jaisor/SolarNodeChargeController/(commit log)

2026-10-28 feat: add CN3791 solar charger schematic with INA219 monitor
    KiCad 10 project for a 1S LiPo charger fed by up to four 5V solar panels,
    built from the CN3791 datasheet's typical application (Figure 1):
    - Panels on J1-J4, each isolated by a 1N5819 onto a shared PV bus.
    - 1.0A charge current (R5 = 0.12R) and a 4.58V MPPT setpoint (R3/R4),
    chosen so diode-isolated 5V panels sit near their max power point.
    - Datasheet blocking diode D1 omitted: the input diodes already stop
    back-feed into the panels, and it frees ~0.4V of headroom.
    - J7/J8 take off-board panel switches (battery cut-off, load only);
    J6 is the VOUT output to the powered module.
    - INA219 (0x40) reads either the solar shunt R7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
    [SolarNodeChargeController.kicad_pcb, SolarNodeChargeController.kicad_sch]
2026-10-28 feat(pcb): add component placement draft
    Place all 36 footprints on a 60 x 29 mm 2-layer board with nets assigned
    and no routing. Solar inputs and their 1N5819s run along the left edge,
    the CN3791 buck stage sits top-middle in current-flow order to keep the
    C1 -> Q1 -> D2 loop short, the INA219 and SOLAR/BATT switch are in the
    middle, and battery/load/switch-lead connectors line the right edge.
    tools/place-pcb.py builds the board with KiCad's pcbnew Python API from
    the schematic netlist and a placement table. It links each footprint to
    its symbol path so "Update PCB from Schematic" matches instead of
    duplicating, and sizes the Edge.Cuts rectangle to the courtyards plus
    0.5 mm.
    Checked with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
    [SolarNodeChargeController.kicad_pcb]
2026-10-28 docs: add README with schematic and board renders
    Describe the board for anyone landing on the repo: features, the
    deviations from the CN3791 reference circuit and why, a connector pinout
    table, INA219 usage (address, shunts, SW3 positions and sign
    conventions), and the repository layout.
    Images live in docs/images/ because output/ is gitignored: the
    schematic as SVG (opaque background, readable in dark mode) and top and
    angled 3D renders of the placement draft from kicad-cli pcb render. The
    README lists the commands to regenerate them.
2026-10-28 feat: shrink board to 42x26 mm with SMD diodes and 1.25 mm connectors
    Input diodes: D5-D8 move from DO-41 1N5819 to SOD-323 1N5819WS (same
    40V/1A rating and pinout). The panels peak at ~200-300 mA each, so the
    large through-hole part bought nothing and cost ~12 mm of board width.
    Connectors: every power connector (solar J1-J4, battery J5, VOUT J6,
    switch leads J7/J8) becomes a 2-pin Micro JST 1.25 / Molex PicoBlade
    vertical header (53047-0210), and the I2C header J9 a 4-pin one
    (53047-0410). The trade-off is that power connectors are no longer
    keyed against each other, so the docs call for clear silkscreen labels.
    Charge current: R5 0.12R -> 0.15R lowers it from 1.0 A to 0.8 A, leaving
    mar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
    [SolarNodeChargeController.kicad_pcb, SolarNodeChargeController.kicad_sch]
2026-10-29 feat(pcb): route the board, add M3 holes, silkscreen and fab packaging
    Board: grows to 56.5 x 29 mm with 2 mm corner chamfers and four
    non-plated M3 holes (H1-H4, added to the schematic as MountingHole
    symbols, excluded from the BOM). The holes sit in 7.5 mm end bands that
    also take SW3 and the I2C connector J9.
    Routing: tools/route-pcb.py is a grid A* router written for this board,
    since no FreeRouting/Java is available here. It fans GND out first (an
    F.Cu stub and via per SMD GND pad; routing signals first left U2 pin 6
    boxed in), routes power nets at 0.8 mm (0.4 mm into small pads) and
    signals at 0.25 mm, Kelvin-connects the sense pins to R5/R6/R7, and pours
    GND on both layers. A turn pe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
    [SolarNodeChargeController.kicad_pcb, SolarNodeChargeController.kicad_sch]
2026-10-29 docs: present the board as a charger for SNAP-style solar mesh nodes
    The README now leads with the intended use: solar LoRa mesh nodes such
    as the SNAP v1.2 enclosure on MakerWorld. It covers what the board
    replaces in that build (the CN3158 module, inline 1N5819s and hand
    wiring), an example wiring table for two FellDen 5V 200mA panels, an
    18650, the on/off switch and a XIAO nRF52840 + Wio-SX1262 node, and
    notes on INA219 detection in Meshtastic/MeshCore and its 0x40 address.
    It also notes that an unused switch connector needs a jumper.
    Images: three photos from the SNAP MakerWorld post (the user's own
    design) in docs/images/snap/, and a wiring diagram drawn by the new
    tools/make-diagram.p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
2026-10-29 refactor: flatten the KiCad project to the repo root
    KiCad's project template nests <name>/<name>/, which left a redundant
    SolarNodeChargeController/ folder holding the whole design. The project
    files (.kicad_pro/.kicad_sch/.kicad_pcb, SolarNode.kicad_sym,
    sym-lib-table) now sit at the repo root, moved with git mv so history
    follows. sym-lib-table uses ${KIPRJMOD}, so the CN3791 symbol still
    resolves.
    The tools default to the repo root: gen-schematic.js and route-pcb.py
    take no argument, place-pcb.py takes just the netlist, and
    fab-package.js defaults to output/fab. README and CLAUDE.md commands and
    paths are updated, and CLAUDE.md notes that the kicad MCP server's
    projects base is now this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
    [SolarNodeChargeController.kicad_pcb, SolarNodeChargeController.kicad_sch]
2026-11-14 feat: SOD-123 input diodes, 0.5 A per input, and ratings on the back
    The SOD-323 1N5819WS on each solar input is only good for about 0.3 A:
    at 0.5 A it dissipates roughly its rated 0.2 W, too much inside a warm
    enclosure. D5-D8 are now 1N5819W in SOD-123, rated here at 0.5 A per
    input.
    The SOD-123 courtyard is 4.7 mm wide and the strip it sits in was
    4.3 mm, so J1, J2 and J4 move 0.45 mm left and J3 0.3 mm (U2 stops it
    there); D6 and D7 sit slightly off their connector's row to clear R7
    and R2. The PV bus moves to x = 19.9, the channel 2 sense hops move
    with it, and the anode tracks widen to 0.6 mm. Outline, mounting holes
    and all other connectors are unchanged. Courtyards now touch, which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
    [SNAP_Power_Controller.kicad_pcb, SNAP_Power_Controller.kicad_sch]
